aprsworld/pcwx/schematic/README.md

# pcwx schematic files

Schematic files for pcwx board. 

Provided as both PDF and [TinyCad](http://tinycad.sf.net) DSN file.
