aprsworld/pcwx/pcb/README.md

# pcwx PCB files

PCB files for pcwx board. 

Board is laid out [FreePCB](http://www.freepcb.com). Netlist comes from the TinyCad. Schematic which can be exported to a netlist is found in the [../schematic/](../schematic/) directory.
