aprsworld/pcwx/(threads)

Thread 2 (2015-09-15):

LVD power control / APO

kb0thn, 2015-09-15:
Should implement LVD on pcwx. Here is how Morningstar does automatic voltage detection.

SYS_V
[76][0x004B] (V). System Voltage.
Reports the selected/detected System Voltage and setsthis register value to “0” for 12V or “1” for
24V. System Voltage is set using the DIP switches (auto-detect, 12V system, 24V system).
System voltage auto-detect only occurs on start-up when the controller is first powered on. If the
battery voltage is less than 15.5 Volts, the controller will operate with 12V settings. The controller
will charge with 24V settings ifBattery voltage above 15.5 Volts.

Thread 3 (2015-10-26):

RCV_ON() in modbus_slave_pcwx.c has extraneous debugging

kb0thn, 2015-10-26:
// Clear RX buffer. Clear RDA interrupt flag. Clear overrun error flag.
	while ( kbhit(MODBUS_SERIAL) ) {
		fprintf(DEBUG,"# reading starting ...");
		fgetc(MODBUS_SERIAL);
		fprintf(DEBUG," complete");
	}

kb0thn, 2015-10-26:
actually a whole bunch of unnecessary debugging

Closed 2015-10-30.

Thread 11 (2015-12-09):

NMEA0183 baud?

kb0thn, 2015-12-09:
Airmar station was configured for 4800. Read 4800 out of register 1013. But wasn't getting data. Wrote 4800 to register 1013 and magically data started happening.

This was after a pcwx cold boot due to power failure.

Verify baud rate is setting on boot.

Closed 2015-12-13.
