aprsworld/pcwx/schematic/pcwx_rev3d_release_20150913.pdf

# Precision 5 volt reference for ADC

## AN_IN_VOLTS

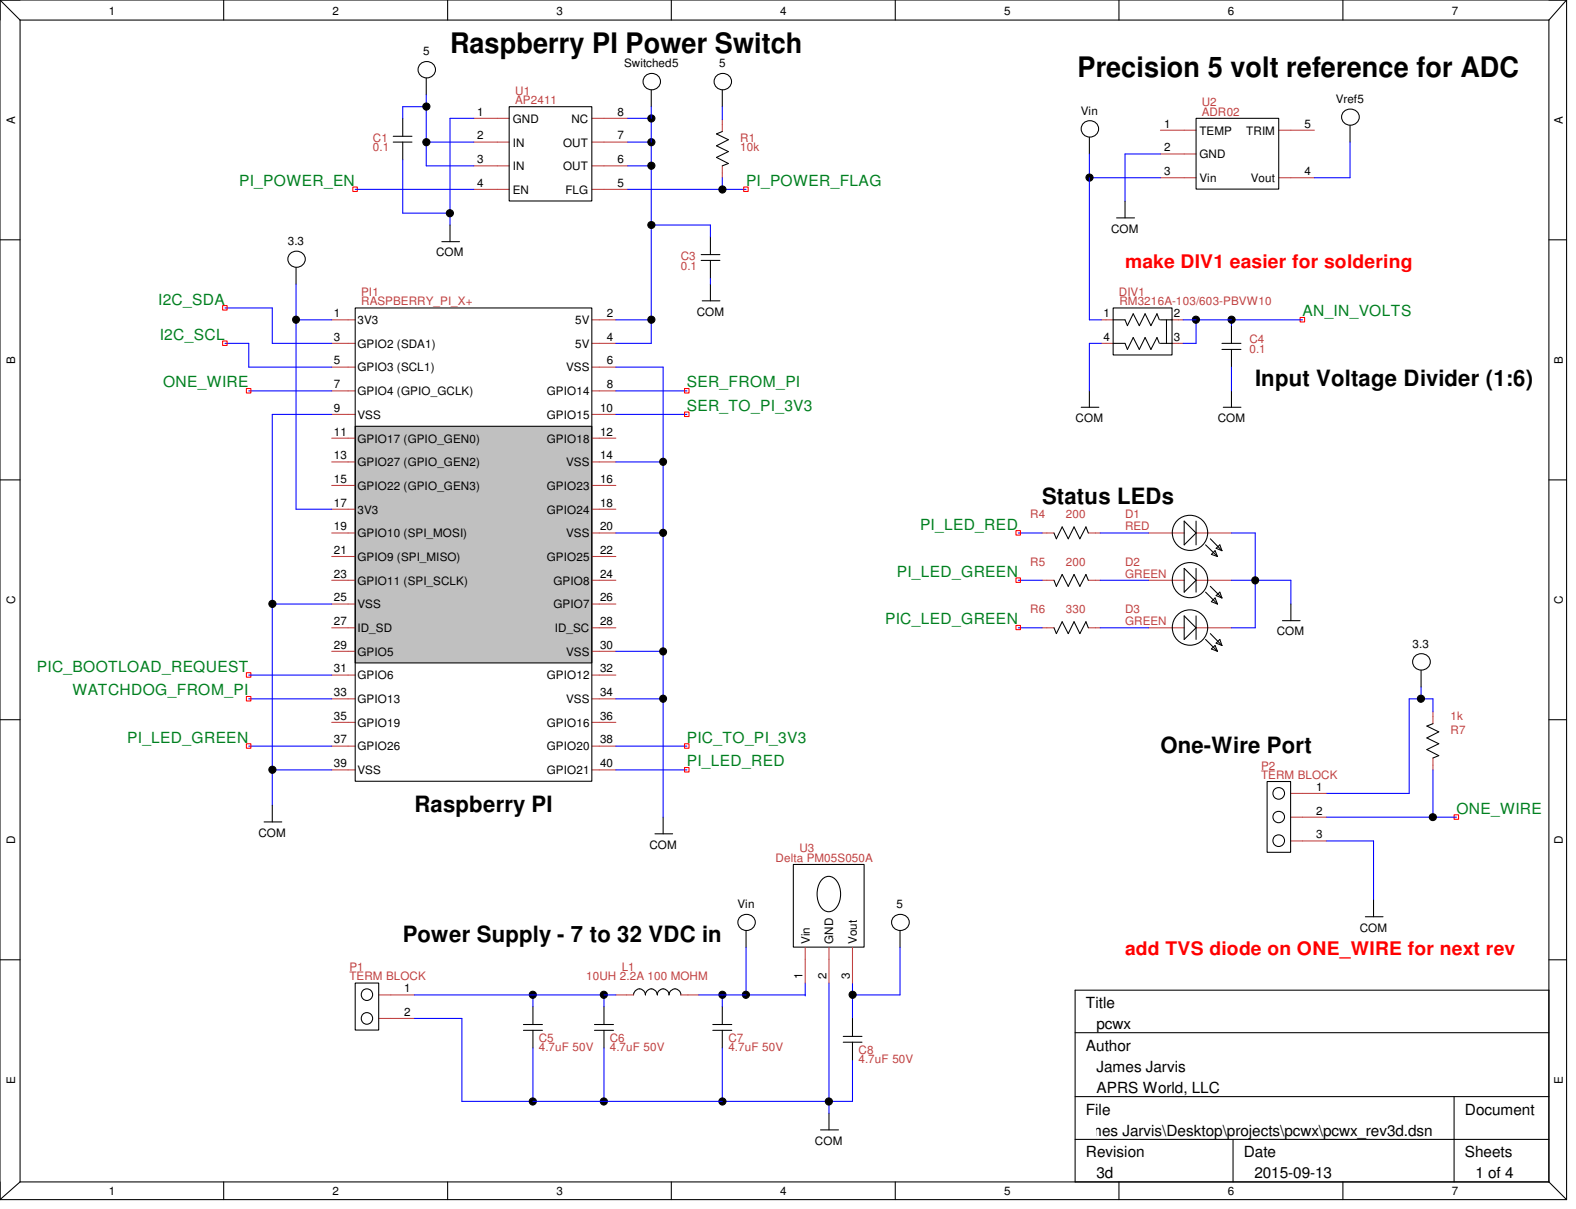
[picture p1: page 1]

Raspberry PI Power Switch

COM
make DIV1 easier for soldering

Power Supply - 7 to 32 VDC in

add TVS diode on ONE_WIRE for next rev

C:\Users\James Jarvis\Desktop\projects\pcwx\pcwx_rev3d.dsn

## AN_TEMPERATURE

## AN_USER_ADC_0

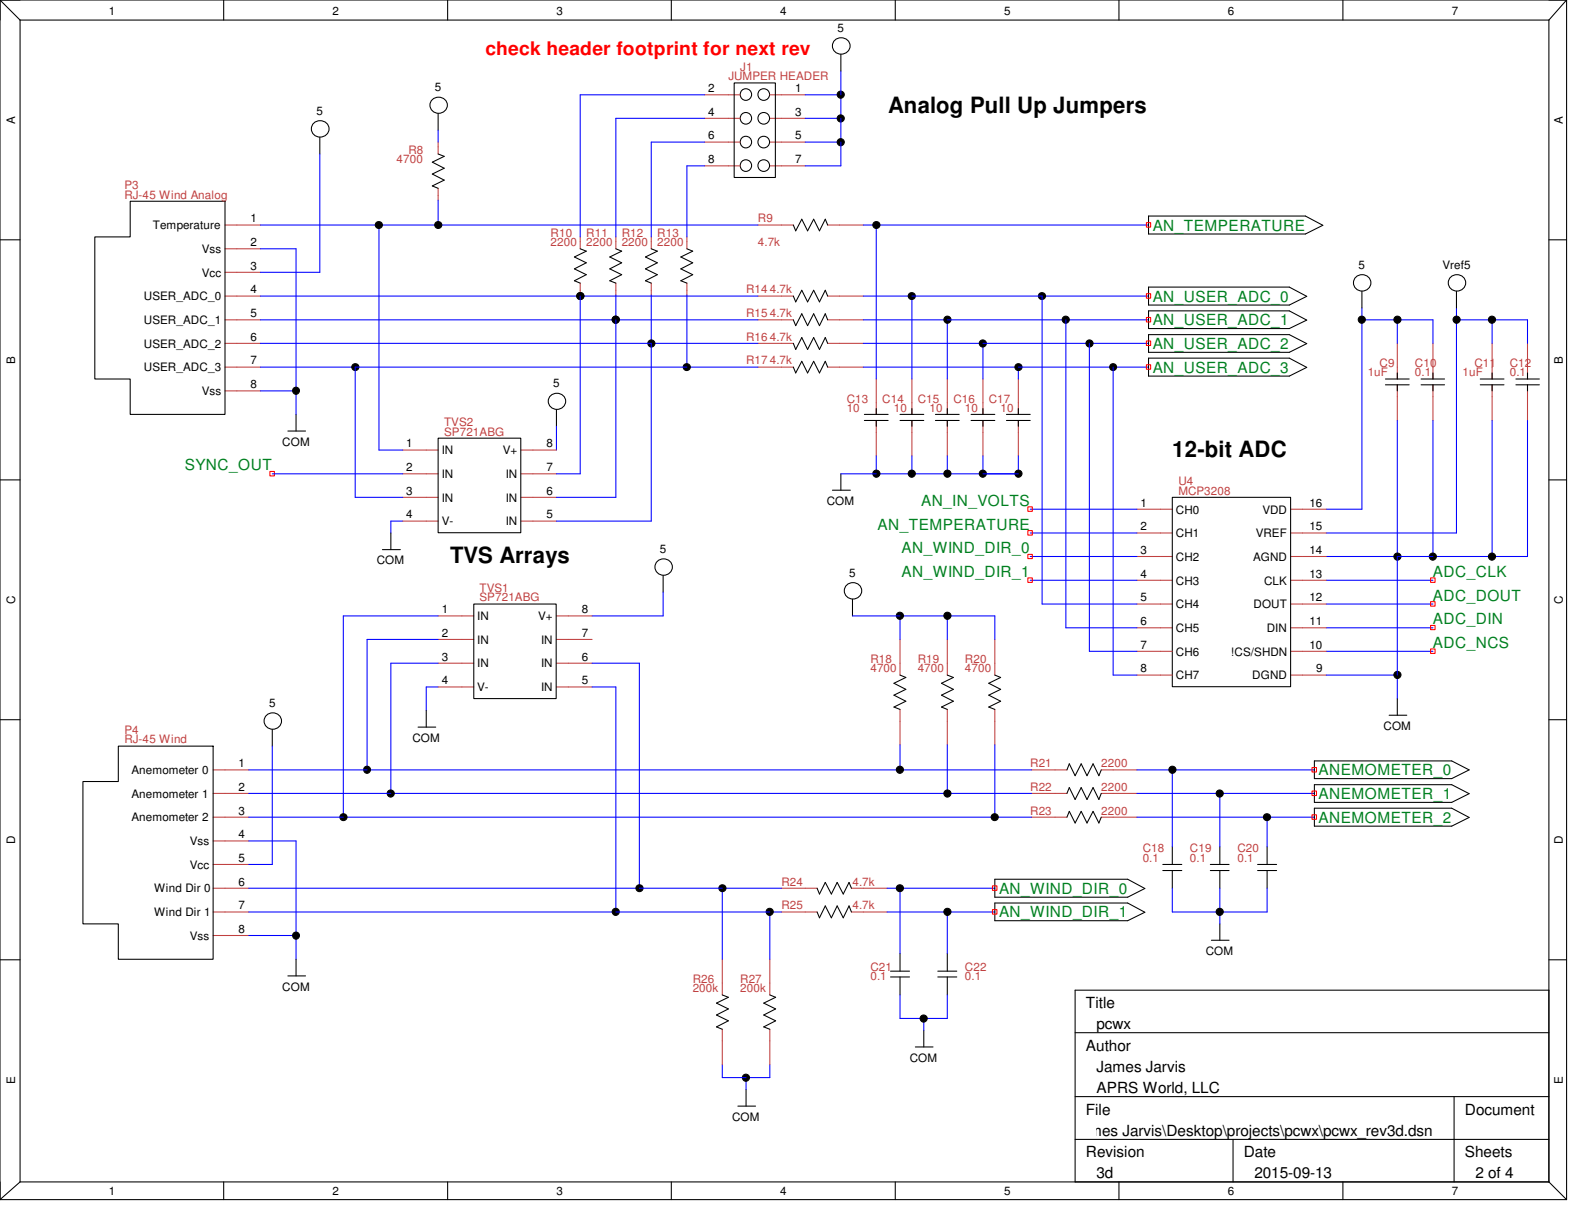
[picture p2: page 2]

check header footprint for next rev

Analog Pull Up Jumpers

C:\Users\James Jarvis\Desktop\projects\pcwx\pcwx_rev3d.dsn

## SER_TO_PI_5V

## SER_FROM_PI

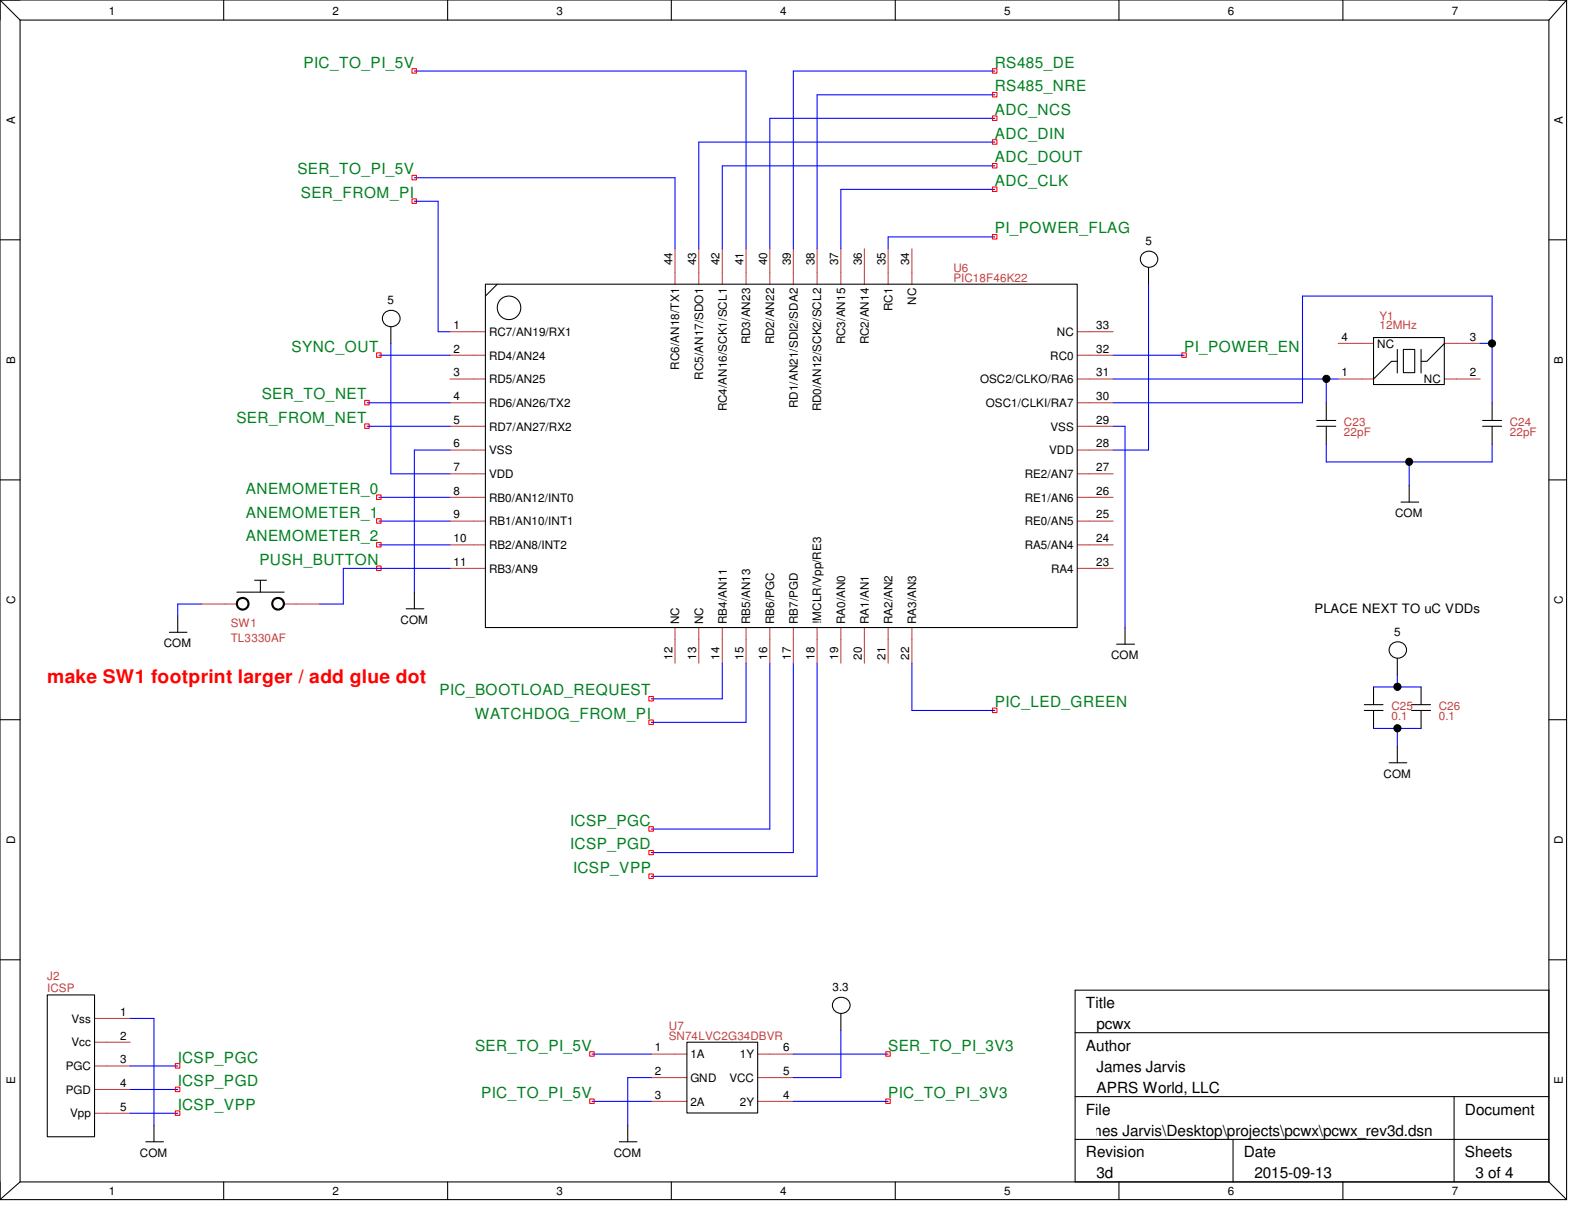
[picture p3: page 3]

PLACE NEXT TO uC VDDs

PIC_BOOTLOAD_REQUEST make SW1 footprint larger / add glue dot

C:\Users\James Jarvis\Desktop\projects\pcwx\pcwx_rev3d.dsn

## I2C_SCL

## I2C_SDA

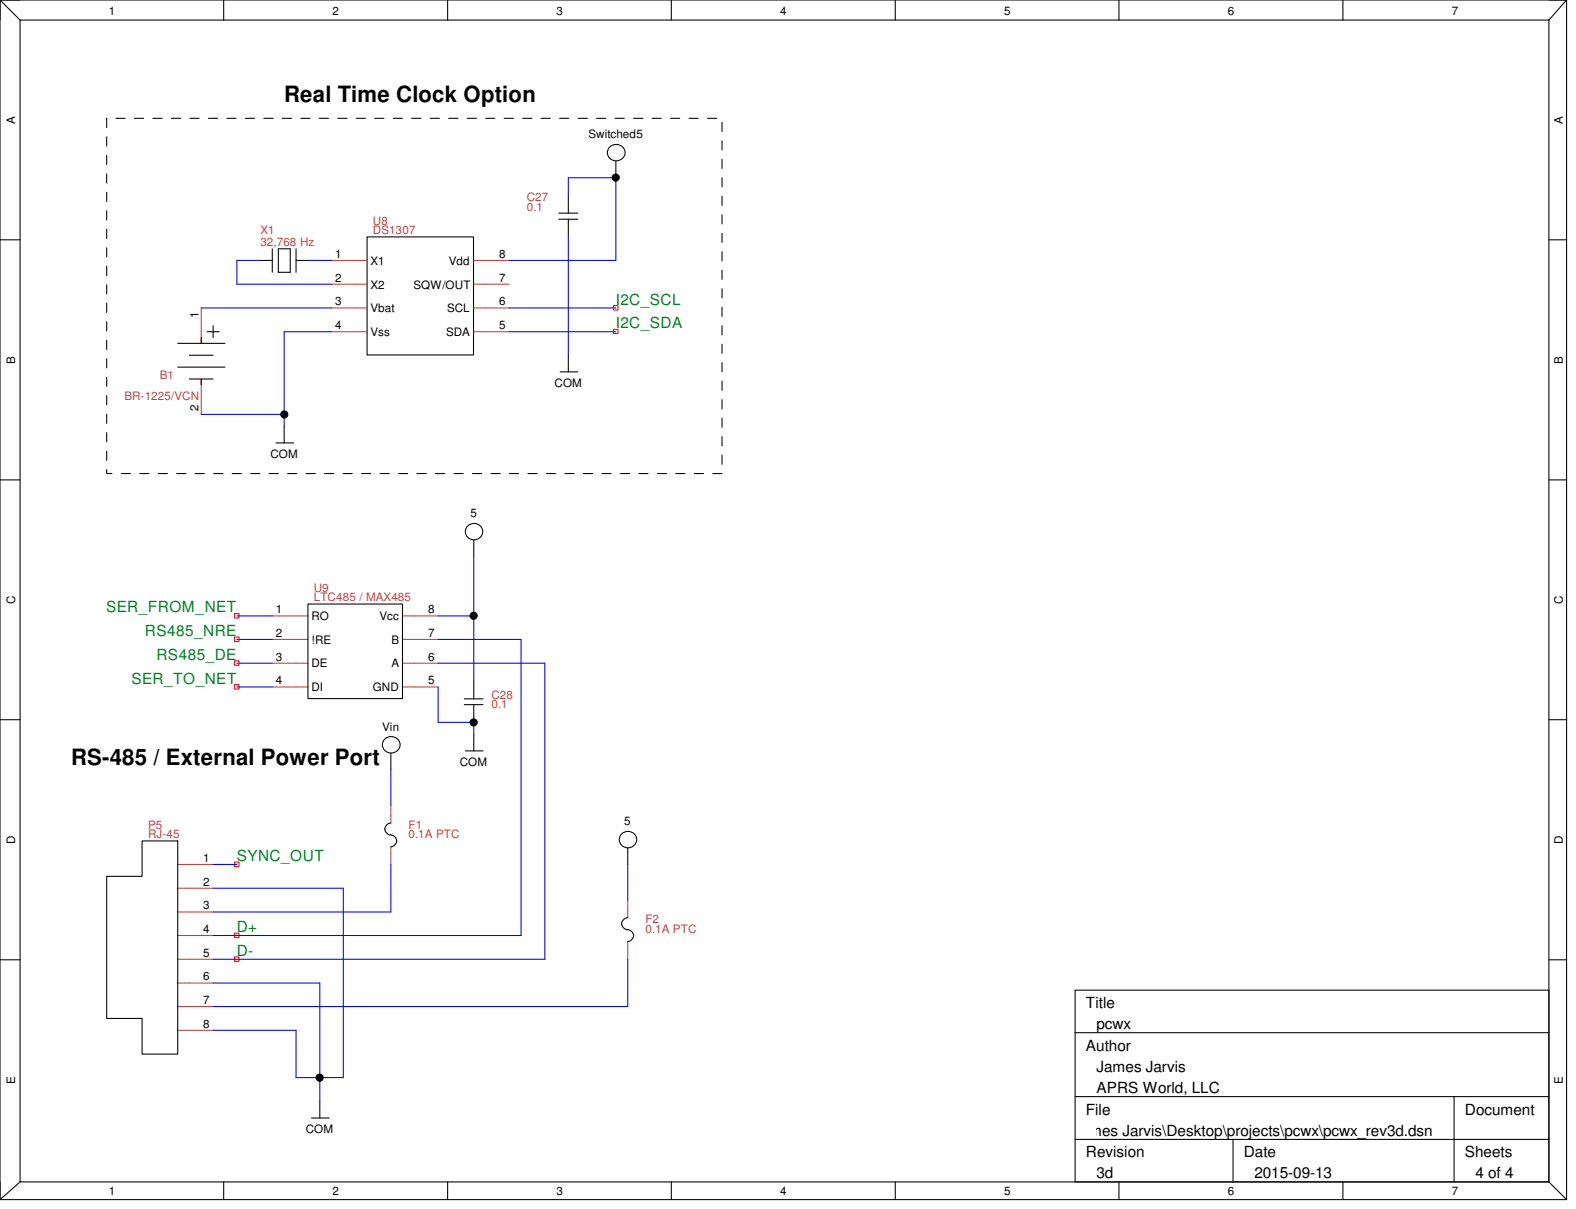
[picture p4: page 4]
Vbat 3; Vss 4; SDA; SCL; SQW/OUT; Vdd; BR-1225/VCN; Switched5; COM; SER_TO_NET; SER_FROM_NET; GND; Vcc; U9 LTC485 / MAX485; RS485_NRE; SYNC_OUT; Vin; 5 F1 0.1A PTC; F2 0.1A PTC; Revision; Document; Date; Sheets

Real Time Clock Option

RS-485 / External Power Port

Title
pcwx
Author
James Jarvis
APRS World, LLC
File

C:\Users\James Jarvis\Desktop\projects\pcwx\pcwx_rev3d.dsn
