aprsworld/pcwx/(list of files, drawings)

Other design files:
schematic/pcwx_rev3d_release_20150913.dsn
