aprsworld/pcwx/(commit log)

2015-04-18 Initial commit of piCameraWeatherX
    a melding of modbus from XRW2G and high(er) precision frequency
    measurement from sdLoggerWind2
    Untested on hardware at this point.
    Hardware has 12 MHz crystal oscillator, so time interrupt setup will
    have to be changed.
2015-04-18 Refractored code to get periodic tasks into 10 millisecond period Added serial port interrupt handlers
2015-04-18 Dialing in the modbus timing. We now timeout if there is more than 2.7 millisecond delay between characters.
2015-04-18 Added config setting to allow the PIC bootload request line to be cause CPU reset.
    The intended process of updating the piCameraWeatherX processor firmware
    is:
    a) set register 1008 to 1 via Modbus
    b)terminate mbusd
    c) start bootloader software on pi
    d) hold PIC_BOOTLOAD_REQUEST line high for 50 milliseconds to cause
    reset
    e) start loading via DS30
2015-04-18 Added watchdog_seconds and watchdog_seconds_max.
    When watchdog hasn't been reset for > watchdog_seconds_max, we power
    cycle the PI target
    [register_list_piCameraWeatherX.xls]
2015-04-18 Added modbus register to view watchdog_seconds
    [register_list_piCameraWeatherX.xls]
2015-04-18 Beginning to add pi offtime seconds
    [register_list_piCameraWeatherX.xls]
2015-04-19 Working on bringing it up. For some reason it isn't working well with the bootloader or the anemometer interrupts turned on
    currently can send messages from the pi to the debug when bridged, but
    not from the debug to the pi
2015-04-20 Figured out the serial port testing issue. The PI serial port needs to have 3.3 volts in order for the logic level converter to work.
2015-04-25 Making progress. Modbus works at 57600 on UART1. Bridge button works. Uptime works. Interval works. Analog 0 works ... but seems to have a slight offset. pulse 0 seems to be working (not yet checked 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
    [register_list_piCameraWeatherX.xls]
2015-06-27 Beginning to make it respond (correctly) to any modbus address is config.modbus_address=255
    [register_list_piCameraWeatherX.xls]
2015-06-27 Spent quite a while reading datasheet and trying to figure out why ADC performance is so terrible. Turns out that the errata sheet for the chip says that the silicon just is terrible. It can have sup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
    [register_list_piCameraWeatherX.xls]
2015-06-28 Decided that PIC18F45K80 was a lost cause. The ADC in it just doesn't do 12 bits. Attempting to replace it with a PIC18F4523 like in the XRW2G. This check in is the last with 45K80 support. It works 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
2015-06-28 Working on getting all ADC channels to read. PIC18F4523 is dumb about chosing analog inputs.
2015-06-28 working on improving ADC accuracy
2015-06-28 Taking a break from the ADC accuracy. Need to review timing calculations and settings.
2015-07-27 pulseMaxPeriod wasn't implemented.
    [register_list_piCameraWeatherX.xls]
2015-07-27 Fixed timing issues. Verified all inputs. Now working on watchdog.
    [register_list_piCameraWeatherX.xls]
2015-07-27 working on watchdog timer
    [register_list_piCameraWeatherX.xls]
2015-07-27 Set the default to pi being powered off when board powers up.
2015-07-27 changed power off seconds to int16. This will allow the thing to programmatically sleep for long periods. Also added modbus register for setting initial power state.
    [register_list_piCameraWeatherX.xls]
2015-09-04 Attempting to branch PIC18F4523 version of firmware off.
    New revision of the hardware (3d) is based on PIC18F46K22.
    [register_list_piCameraWeatherX.xls]
2015-09-04 Beginning to port to PIC18F46K22. Compiles. Won't run.
    Need to set tri states and add MCP3208 ADC support.
2015-09-04 Bringing up the hardware.
    [register_list_piCameraWeatherX.xls]
2015-09-04 Adding MCP3208 ADC support
2015-09-04 About to test MCP3208 ADC
2015-09-04 ADC seems to work. Analog average values aren't.
    Button works! Was mechanically bad.
    [register_list_piCameraWeatherX.xls]
2015-09-13 Testing RS-485 firmware
    [register_list_piCameraWeatherX.xls]
2015-09-13 Renamed files to new pcwx convention.
    [register_list_pcwx.xls]
2015-09-13 Adding board schematic.
    [pcwx_rev3d_release_20150913.dsn]
2015-09-13 Adding rev3d PCB gerbers.
2015-09-13 Adding PCB documentation and files.
2015-09-13 schematic documentation
2015-10-12 Bringing up without boot loader.
    ADC not adverging was because default parameters aren't automatically
    loading. And the ADC sample ticks came up as 0xffff ... which takes a
    while to happen.
    [register_list_pcwx.xls]
2015-10-30 removed debugging from modbus_slave and set respond to any modbus address to be 128
    [register_list_pcwx.xls]
2015-11-03 Updated register list for modbus gateway
    [register_list_pcwx.xls]
2015-11-20 Beginning to add NMEA 0183 receive support
    [register_list_pcwx.xls]
2015-11-20 Developing NMEA0183 register map
    [register_list_pcwx.xls]
2015-11-20 NMEA sentence config
    [register_list_pcwx.xls]
2015-11-20 Now receiving data on RS-485 and putting in proper slot
2015-11-23 Trying to get NMEA0183 receiving working again
    added byte counters on rda and rda2
    [register_list_pcwx.xls]
2015-11-23 Seem to be get trailing characters on sentence
    [register_list_pcwx.xls]
2015-11-23 Added code to set speed of RS-485 port. Now to test.
    [register_list_pcwx.xls]
2015-11-23 Modbus data is buffered before transmitting.
    Need to make sure this doesn't adversely affect high resolution timing
    too badly.
    [interrupt_pcwx.c, modbus_slave_pcwx.c, pcwx.c]
2015-11-23 Reduced modbus timeout to make response faster.
    Timeout (timer0) was initial set for 4 milliseconds. Which is 3.5
    characters at 9600. But now at 57600 we were much to slow. And timeout
    in code was based on f_osc (12 MHz), not f_osc / 4 (3 MHz) which is what
    timer 0 is apparently clocked at.
    closes #1
2015-12-07 Fixed bug with NMEA string copy. Now it won't overrun the end of the buffer.
    [register_list_pcwx.xls]
2015-12-07 Added NMEA sentence META. Added button state.
    [register_list_pcwx.xls]
2015-12-13 Added NMEA0183 wild card for match. I seem to have forgotten to commit.
    [register_list_pcwx.xls]
2016-03-20 Added magnetic latch to PIC_TO_PI. About to test in hardware.
    [register_list_pcwx.xls]
